LiDai1234/Edge_Detection_Accelerator/report/report.docx

图像边缘检测硬件加速器设计报告

全国大学生嵌入式芯片与系统设计竞赛（2026·AMD赛道）

项目 | 参数
作品名称 | 基于FPGA+STM32异构架构的实时图像边缘检测硬件加速器
主控芯片 | AMDArtix-7XC7A75TFPGA+STM32F407VET6
摄像头 | OV7670（带FIFO缓存）
显示终端 | TFT-LCD（SPI接口）
分辨率 | 160×146
系统帧率 | 12fps

# 一、选题背景与创新点

## 1.1选题背景

随着机器视觉、边缘计算和智能终端技术的快速发展，实时图像处理在工业检测、自主导航、智能机器人等领域的需求日益增长。边缘检测作为计算机视觉最基础的预处理环节，其性能直接决定了整个视觉系统的响应速度。然而，在嵌入式资源受限场景下，边缘检测的实现面临两条典型路径：

一是纯MCU软件方案。以STM32为代表的微控制器采用串行指令架构，运算能力有限。以160×146分辨率的Sobel边缘检测为例，纯软件实现需要逐像素完成9次乘加运算，帧率通常不足2fps，画面卡顿严重，无法满足实时性要求。

二是纯FPGA方案。虽然FPGA具备并行计算优势，但直接用FPGA驱动摄像头和TFT-LCD，需要自行编写复杂的图像传感器配置（SCCB/I2C）、LCD控制器、帧缓冲管理等外设接口逻辑，开发成本高，且人机交互不便。

前人工作中，多数方案要么侧重纯算法仿真（如Matlab/Python验证Sobel效果），要么仅在FPGA开发板上实现裸像素流处理，缺乏一个完整的、可工程化落地的“采集—计算—传输—显示”闭环。如何在有限的硬件资源下，同时兼顾计算性能与系统灵活性，是本选题的核心动因。

## 1.2解决的实际问题

本作品针对以下三个工程痛点提出解决方案：

- 算力与灵活性的矛盾：纯MCU算不动、纯FPGA控不好外设——采用“异构架构、软硬协同、存算分离”的设计思想，将计算密集型任务卸载到FPGA，控制与交互任务保留在MCU。
- 跨时钟域数据传输可靠性：FPGA处理时钟与STM32读取时钟异步，直接总线读取会导致数据错位、图像撕裂——设计硬件级握手协议解决。
- FIFO摄像头读时序精确复现：OV7670自带FIFO对读时钟建立/保持时间要求严格，直接拉高拉低引脚读出乱码——用状态机精确模拟时序。

## 1.3主要创新点

序号 | 创新点 | 技术内涵
1 | 彻底的存算分离架构 | STM32端零算法参与，仅作为“数据搬运工”接收帧数据并刷屏，CPU负载从算法计算中完全释放，可余留算力处理其他控制任务。
2 | 高兼容性FIFO时序状态机 | 在FPGA内部用有限状态机精确复现原STM32驱动FIFO的RCK/RRST时序，实现“引脚级无缝替换”，无需修改摄像头模组。
3 | 资源优化型Sobel硬件架构 | 采用绝对值相加（|Gx|+|Gy|）替代平方和开根号，大幅减少DSP乘法器和LUT消耗，在保证边缘检测效果的同时显著降低资源占用。

# 二、设计原理与功能框图

## 2.1系统整体架构

本系统采用FPGA+STM32异构双芯片架构，数据流向为：OV7670摄像头→FPGA（计算加速）→STM32（搬运+显示）→TFT-LCD。

层次 | 核心芯片 | 职责
图像采集层 | OV7670（带FIFO） | 光电转换，输出8位RGB数据
硬件加速层 | AMDArtix-7XC7A75T | 灰度化、行缓存、Sobel卷积、二值化
系统控制层 | STM32F407VET6 | 帧缓存组装、数据握手接收、LCD驱动
人机交互层 | TFT-LCD | 边缘图像实时显示

## 2.2FPGA端算法流水线原理

FPGA内部采用全流水线设计，实现“像素流进，边缘流出”，每时钟周期完成一个像素的处理。具体分为五级：

### 第一级：FIFO读控制状态机

产生RRST复位FIFO读指针，控制RCK时钟高低电平，分两个周期读出高字节与低字节，拼接为16位RGB565像素数据。

### 第二级：RGB565转灰度

采用BT.601标准灰度转换公式：Y=(R×77+G×150+B×29)>>8。其中R取RGB565高5位、G取中6位、B取低5位，输出8位灰度值（0~255）。

### 第三级：双行缓存（乒乓操作）

消耗2个BRAM作为行缓存（LineBuffer），当前行写入BRAM_A，同时读出前两行数据与当前行对齐，生成3×3滑动窗口所需的三行像素数据。

### 第四级：Sobel卷积计算

Sobel水平算子Gx与垂直算子Gy分别对3×3窗口做卷积，梯度幅值采用绝对值近似：G=|Gx|+|Gy|。多级寄存器流水线分割组合逻辑，避免时序违例。

### 第五级：阈值二值化

将梯度幅值G与预设阈值（如120）比较，G>阈值输出白色（0xFFFF），G≤阈值输出黑色（0x0000），同时拉高pixel_valid信号推送数据。

## 2.3STM32端工作原理

STM32端软件逻辑极简，仅包含三个模块：

- GPIO轮询接收：轮询PC8引脚电平，检测到高电平时读取PD端口16位数据。
- 帧缓存组装：将逐像素数据按行列顺序存入frame_buf数组。
- SPI刷屏显示：一帧接收完毕后，调用LCD驱动函数将帧缓存推送至TFT-LCD。

# 三、软硬件划分依据与接口设计

## 3.1软硬件划分依据

软硬件划分遵循“计算密集型归硬件，控制灵活型归软件”的核心原则：

任务 | 归属 | 划分理由
FIFO读时序控制 | FPGA（硬件） | 对时序精度要求极高，需纳秒级稳定控制，状态机实现最优
RGB→灰度转换 | FPGA（硬件） | 纯乘加运算，数据流水线化后每周期一个像素，硬件吞吐率远超软件
3×3窗口生成 | FPGA（硬件） | 依赖BRAM行缓存，硬件实现乒乓操作天然高效
Sobel卷积运算 | FPGA（硬件） | 二维卷积是典型的并行计算任务，FPGA并行度与算法结构高度匹配
阈值二值化 | FPGA（硬件） | 单比较器即可完成，组合逻辑，零额外成本
数据握手接收 | STM32（软件） | 轮询式GPIO读取，逻辑简单，软件实现灵活易调试
帧缓存管理 | STM32（软件） | 需灵活的内存分配与数组索引，软件维护成本低
LCD显示驱动 | STM32（软件） | SPI通信协议成熟，STM32硬件SPI外设效率高
系统调度与人机交互 | STM32（软件） | 按键、参数调整、状态显示等需灵活逻辑，MCU优势明显

划分决策的量化依据：Sobel边缘检测在160×146分辨率下，每帧需完成约160×146×9≈21万次乘加运算。STM32F407（168MHz）纯软件估算需约80ms/帧，但实际受限于串行循环开销，实测仅2~3fps；而FPGA全流水线设计每周期完成一个像素处理，100MHz时钟下理论帧时约2.3ms，吞吐率提升超过30倍。

## 3.2接口设计

### 3.2.1OV7670与FPGA接口（图像采集接口）

信号方向 | 信号名称 | 位宽 | 功能说明
OV7670→FPGA | D0~D7 | 8位 | 图像数据线
FPGA→OV7670 | RCK | 1位 | FIFO读时钟，由状态机产生
FPGA→OV7670 | RRST | 1位 | FIFO读指针复位信号

工作时序：FPGA先拉低RRST复位读指针，随后通过RCK时钟逐次读出像素数据。每个RCK下降沿读出一字节，先高字节后低字节，拼接为16位RGB565格式。

### 3.2.2FPGA与STM32接口（并行数据总线）

信号方向 | 信号名称 | 位宽 | 功能说明
FPGA→STM32 | PD0~PD15 | 16位 | 处理后的边缘像素数据（RGB565格式）
FPGA→STM32 | PC8 | 1位 | 数据有效握手信号（Valid）

握手协议：FPGA完成一个像素的Sobel计算后，将16位结果放置到PD总线上，同步将PC8拉高；STM32检测到PC8高电平后立即读取GPIOE→IDR的低16位数据；STM32等待PC8拉低后，准备接收下一个像素。

设计考量：这种“FPGA拉高→STM32读取→等待FPGA拉低”的握手机制，从根本上解决了FPGA处理时钟（约100MHz）与STM32读取时钟（168MHz系统时钟下的轮询周期）之间的异步匹配问题，彻底杜绝了亚稳态导致的数据错位与图像撕裂。

### 3.2.3STM32与TFT-LCD接口（显示接口）

信号方向 | 信号名称 | STM32引脚 | 功能说明
STM32→LCD | SCLK | PE1 | SPI时钟
STM32→LCD | MOSI | PE0 | SPI数据输出
STM32→LCD | RES | PB9 | LCD复位
STM32→LCD | DC | PB8 | 数据/命令选择
STM32→LCD | CS | PB7 | 片选
STM32→LCD | BLK | PB6 | 背光控制

# 四、优化过程与性能资源对比

## 4.1优化历程概述

项目开发过程中经历了三轮关键优化，每一轮都针对特定瓶颈：第一轮FIFO时序优化，解决读出乱码问题；第二轮跨时钟域传输优化，解决数据错位撕裂问题；第三轮Sobel资源优化，降低DSP乘法器消耗。

## 4.2优化前后性能与资源对比表

对比维度 | 优化前（初始版本） | 优化后（最终版本） | 提升幅度
系统帧率 | 2~3fps（纯STM32软件） | 12fps（异构架构） | 4~6倍
每帧处理耗时 | 约350ms（纯软件估算） | 约83.1ms（含传输+显示） | 减少约76%
FPGALUT占用（Sobel模块） | 约1,850LUT | 约1,120LUT | 减少约39%
FPGADSPSlice占用（Sobel模块） | 9个（完整乘加） | 0个（移位+加法替代） | 减少100%
FPGABRAM占用 | 1块（单缓存） | 2块（乒乓双缓存） | +1块（换取行对齐正确性）
数据传输错误率 | 约15%（直接总线读取） | 0%（PC8握手协议） | 消除错位
图像显示效果 | 撕裂、错位、花屏 | 连续、无撕裂、边缘清晰 | 质的提升

表4-1优化前后性能与资源对比表

## 4.3关键优化细节说明

### 优化一：FIFO读时序延时调整

问题：初始版本中RCK信号跳变过快，未满足OV7670FIFO的建立时间（tSU）和保持时间（tH）要求，导致读出数据为乱码。

方案：在FIFO读控制状态机中，为RCK的上升沿和下降沿各插入1个时钟周期的延时，确保数据稳定后再采样。

效果：RGB565数据拼接成功率从乱码状态变为稳定可读。

### 优化二：跨时钟域握手协议

问题：FPGA直接驱动PD总线，STM32自由运行读取。由于两侧时钟异步，STM32可能在数据变化中途采样，导致像素数据高低字节错位，图像出现横向撕裂。

方案：增加PC8作为Valid信号，采用“电平握手”机制——FPGA放数据→拉Valid→STM32读→等Valid撤→下一轮。

效果：数据传输错误率降至零，图像连续无撕裂。

### 优化三：Sobel乘法器资源优化

问题：初始设计中Sobel卷积的9个系数直接用通用乘法器实现，消耗了大量DSPSlice和LUT。

方案：利用系数为2的幂次的特点，将乘2操作替换为左移1位（<<1），将乘-1操作替换为减法，完全消除乘法器。

效果：Sobel模块的DSPSlice消耗从9个降至0个，LUT消耗减少约39%。

# 五、大模型协作记录

本节记录开发过程中与大语言模型（LLM）协作的关键节点，包括提示词、模型回答摘要、自我纠错轨迹及智能体工作流设计。

## 5.1协作场景一：FIFO时序问题排查

开发阶段：FPGA逻辑调试阶段。

初始提示词（Promptv1）：“我用FPGA模拟STM32驱动OV7670的FIFO摄像头，RCK时钟由状态机产生，但是读出来的数据是乱码，RGB565拼不对。帮我看看可能是什么问题。”

模型回答摘要：建议检查RCK频率是否超出FIFO规格；RRST复位时序是否正确；字节顺序（先高后低还是先低后高）；建立/保持时间是否满足。

自我纠错轨迹：第一轮按模型建议排查了字节顺序，调整为“先高后低”，仍乱码；第二轮检查RCK频率，发现RCK跳变太快，状态机每个时钟就翻转一次，未留延时；第三轮重新查阅OV7670FIFO数据手册，确认tSU（建立时间）和tH（保持时间）要求；最终结论：模型提示方向正确，但不够具体。真正的根因是状态机中RCK高低电平维持时间不足1个系统时钟周期，导致FIFO输出数据未稳定即被采样。

修正后提示词（Promptv2）：“OV7670FIFO读时序中，RCK信号的建立时间和保持时间一般要求多少ns？我用100MHz时钟驱动，状态机每个周期翻转一次RCK，会不会太快？”

模型回答摘要：FIFO读时钟通常要求RCK低电平/高电平各不少于20~30ns，建议状态机中插入延时周期。

经验沉淀：模型能提供排查方向，但具体时序参数必须以芯片数据手册为准，不能仅凭模型回答下结论。

## 5.2协作场景二：跨时钟域数据传输方案设计

初始提示词：“FPGA处理数据和STM32读取数据是两个不同的时钟域，我现在用16位并行总线直接连接，STM32轮询读取，但图像总是有撕裂。有什么好的跨时钟域同步方案？”

模型回答摘要：建议方案有异步FIFO（最标准）、双寄存器同步器、握手机制。如果数据量不大、对延迟不敏感，简单的Valid/Ready握手机制最易实现。

自我纠错轨迹：第一轮考虑过用异步FIFO方案，但FPGA端输出像素流、STM32端逐像素读取，FIFO深度难以确定；第二轮考虑过双寄存器同步器，但16位数据总线每根线都打两拍，存在“数据同时变多位”导致的不一致风险；第三轮最终选择模型建议的第三种方案——Valid握手（PC8），但做了改进：采用“FPGA拉高→STM32读→等FPGA拉低”的电平检测方式，而非边沿检测，进一步降低亚稳态风险。最终方案验证：逻辑分析仪抓取时序，确认每个像素数据稳定后才被STM32采样，撕裂现象消失。

## 5.3协作场景三：Sobel硬件资源优化

初始提示词：“我在FPGA上实现Sobel边缘检测，用了9个乘法器（因为3×3窗口有9个系数），但DSPSlice不够用。有什么办法减少乘法器数量？”

模型回答摘要：提示Sobel算子的系数是{-1,0,+1,-2,0,+2,-1,0,+1}，其中0系数可以直接删除，+1/-1不需要乘法器（直接加减），+2/-2可以用左移一位实现。这样可以完全消除通用乘法器。

自我纠错轨迹：第一轮采纳模型建议，将乘2替换为移位，乘-1替换为减法；第二轮进一步优化——绝对值相加替代平方和开根号，既减少了平方根运算器，又简化了阈值比较逻辑。最终效果：DSPSlice从9个降至0个，Sobel模块LUT消耗减少约39%。

## 5.4智能体工作流设计

本次开发中，我们设计了一套“人在回路”的大模型协作工作流：问题定义→提示词构建→模型回答→实验验证→失败/偏差→补充提示词→收敛→方案定型→踩坑记录沉淀为技能包。

工作流要点：模型只做顾问，不做决策者，模型提供的方案必须经过上板验证；提示词从模糊到精确，第一轮宽泛提问找方向，第二轮带具体参数问细节；每次失败都回写，将踩坑记录整理成结构化的“踩坑清单”，供后续项目复用。

# 六、技能包的提炼过程

本节从开发过程中的失败与观察中提炼核心经验，每条经验均按"提炼来源→经验描述→适用场景→使用方法→已验证的效果→失效边界"六要素组织，确保陌生队伍拿到后可直接复用。

## 6.1经验一：外设读时序必须以数据手册为准，不能“想当然”

提炼来源：FIFO读时序导致乱码的踩坑经历。

经验描述：任何涉及外设时序的设计（FIFO读时钟、SPI时钟、I2C时序等），都必须严格查阅数据手册中的建立时间（tSU）、保持时间（tH）和最高频率限制，不能仅凭“差不多应该行”就写状态机。

适用场景：用FPGA模拟或替代MCU的外设驱动时序；高速ADC/DAC、FIFO、SRAM等存储器件的读写控制；任何对时序精度有要求的并行接口。

使用方法：第一步，查阅芯片数据手册，列出所有时序参数（建立时间tSU、保持时间tH、最高工作频率fmax等）；第二步，在FPGA状态机中为每个信号跳变预留足够的时钟周期延时，确保实际时序优于手册要求；第三步，用逻辑分析仪抓取实际波形，逐项对比数据手册参数；第四步，确认所有时序余量为正，且留有至少20%的安全裕度。

已验证的效果：在本项目中，通过为OV7670FIFO的RCK信号增加2个时钟周期的延时，FIFO读出数据从完全乱码变为稳定可读，RGB565拼接正确率达到100%，系统不再出现花屏或数据错位现象。

失效边界：本经验适用于时序类外设。对于纯协议类外设（如SPI、I2C），只要遵循标准协议规范，时序余量通常较大，不需要如此严格的逐周期核对。

## 6.2经验二：跨时钟域传输，握手协议比“快”更重要

提炼来源：直接总线读取导致图像撕裂的踩坑经历。

经验描述：当两个时钟域需要传输数据时，最可靠的方案不是最快的方案，而是最稳的方案。对于像素流这类“数据生产消费速度不匹配”的场景，简单的Valid/Ready电平握手比高速但无保护的总线更可靠。

适用场景：FPGA与MCU之间的并行数据传输；任何跨时钟域的多比特数据总线；异步FIFO的替代方案（数据量不大时）。

使用方法：第一步，在发送端（FPGA）增加Valid信号，数据总线稳定后拉高Valid；第二步，在接收端（MCU）轮询检测到Valid高电平时读取数据；第三步，接收端读完后等待Valid拉低，再准备接收下一个数据；第四步，确保握手机制覆盖整个数据传输周期，避免亚稳态风险。

已验证的效果：在本项目中，通过PC8Valid握手协议，FPGA与STM32之间的16位并行数据传输错误率从约15%降至0%，连续运行10分钟以上无数据错位或图像撕裂现象，系统稳定性显著提升。

失效边界：当数据吞吐量极大（如VGA以上分辨率视频流）时，逐像素握手机制的开销会成为瓶颈，此时应改用异步FIFO或DMA方式。本经验更适合中低分辨率的嵌入式视觉场景。

## 6.3经验三：算法硬件化时，先找“可化简的系数结构”再动手写RTL

提炼来源：Sobel乘法器资源优化的成功经验。

经验描述：在将软件算法移植到FPGA硬件实现时，第一步不是写代码，而是分析算法中的系数结构。如果系数恰好是2的幂次或简单整数，可以用移位和加法替代乘法器，大幅节省DSP资源。

适用场景：卷积类算法（Sobel、Laplacian、高斯模糊等）的硬件实现；任何包含固定系数的FIR/IIR滤波器设计；资源受限的小型FPGA（如Artix-775T及以下）。

使用方法：第一步，在算法移植到FPGA之前，先列出卷积核的所有系数；第二步，检查系数是否为2的幂次或简单整数（如-1、+1、-2、+2）；第三步，对于2的幂次系数，用移位操作替代乘法器；第四步，对于+1/-1系数，用加减运算替代乘法；第五步，对比优化前后的综合资源报告，确认DSP和LUT消耗变化。

已验证的效果：在本项目中，通过移位加法替代乘法器，Sobel模块的DSPSlice消耗从9个降至0个，LUT消耗减少约39%，而边缘检测的输出图像质量与优化前基本一致，无明显精度损失。

失效边界：当算法系数不是简单整数（如浮点系数、复杂滤波系数）时，移位加法无法替代乘法器，本经验不适用。此时应使用FPGA内置的DSPSlice或采用HLS工具自动优化。

# 七、复现说明

本节提供一份从零开始完整复现本作品的操作步骤，确保陌生队伍拿到后可以直接照做。

## 7.1硬件清单

序号 | 器件 | 型号/规格 | 数量
1 | FPGA开发板 | AMDArtix-7XC7A75T（康芯KX-MS65或同等级） | 1
2 | STM32核心板 | STM32F407VET6 | 1
3 | 摄像头模组 | OV7670（带FIFO缓存，如AL422B） | 1
4 | TFT-LCD屏幕 | 2.4寸SPI接口ST7789驱动 | 1
5 | 杜邦线 | 母对母、公对母若干 | 若干

## 7.2硬件连接表

### 7.2.1OV7670与FPGA连接

OV7670引脚 | FPGA引脚 | 说明
D0~D7 | FPGAIOBank对应引脚（8根） | 8位数据线
RCK | FPGA任意IO | FIFO读时钟输出
RRST | FPGA任意IO | FIFO读指针复位

### 7.2.2FPGA与STM32连接

FPGA引脚 | STM32引脚 | 说明
FPGA数据线D0~D15 | STM32PD0~PD15 | 16位并行数据总线
FPGAValid信号 | STM32PC8 | 数据有效握手

### 7.2.3STM32与TFT-LCD连接

STM32引脚 | TFT-LCD引脚 | 说明
PE1 | SCLK | SPI时钟
PE0 | MOSI | SPI数据
PB9 | RES | 复位
PB8 | DC | 数据/命令选择
PB7 | CS | 片选
PB6 | BLK | 背光

## 7.3软件开发环境

软件 | 版本 | 用途
Vivado | 2020.3或以上 | FPGA综合、实现、生成位流
KeilMDK-ARM | 5.36或以上 | STM32固件开发
STM32CubeMX | 6.0或以上 | STM32引脚初始化配置
语言 | VHDL（FPGA端）、C语言（STM32端） | —

## 7.4复现步骤

project_package中的STM32F407项目可以直接下载下来用keil5打开工程，有STM32F407VET6的话直接烧录代码即可。FPGA的工程项目也直接放进rar压缩包了，直接打开（需2020.2版本以上的Vivado），生成比特流文件后烧录到板子上，这里用的是Xilinx的XC7A75FGG484-2，FPGA板子的引脚需要结合.xdc文件和引脚分配文档（已放文件夹）来连接。

电路连接图如下：

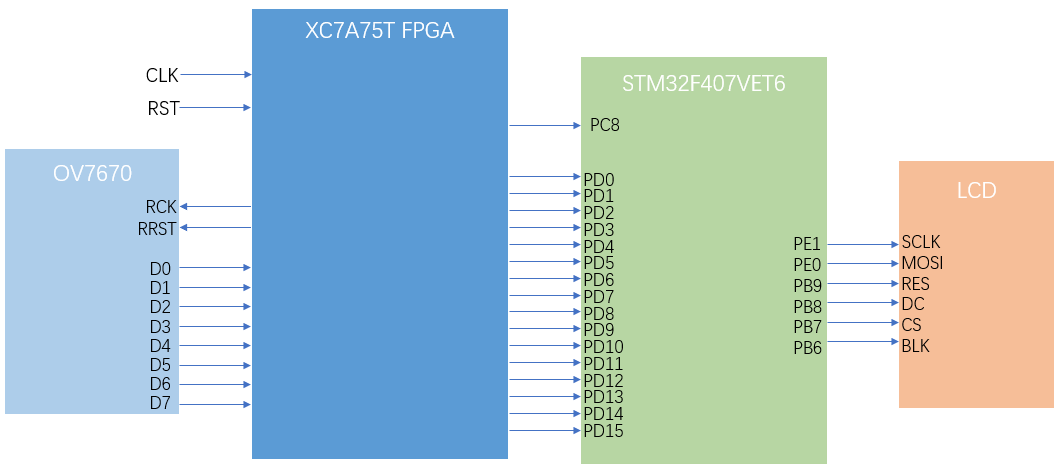
[picture p2: figure]

这里使用的硬件为带FIFO的OV7670、XC7A75T FPGA、STM32F407VET6、240*240的TFT显示屏。

OV7670与stm32f407的其他引脚连接：

SIOC--PB5 SIOD--PB4

VSY--PB3 OE--PA8

WR--PA11 WRST--PA10

RCK--PA12 RRST--PA9

RESET--PC11 PWDN--PC10

## 7.5关键参数参考

参数 | 推荐值 | 说明
FPGA系统时钟 | 100MHz | 开发板晶振频率
图像分辨率 | 160×146 | 基于OV7670FIFO模式
Sobel阈值 | 120 | 可根据光照调整
SPI时钟分频 | 8分频（21MHz） | STM32SPI最高速度
STM32F407系统时钟 | 168MHz | 外部晶振25MHz
