LiDai1234/Edge_Detection_Accelerator/data/README.md

可能出现的问题及解决部分：  
1.配置ov7670的寄存器0x70和0x71进入彩条模式时，如果已经出现竖直彩条，  
&nbsp;&nbsp;但彩条在向右移动（如图picture_4）则大概率是WRST没复位成功，拉低时延时一段时间再拉高  
2.出现picture_3这种情况时，大概率是一个像素对应的两个字节位置反了，要么接线换下位置，要么代码改下像素的高地字节  
3.picture_2是不加FPGA进去，将OV7670的D0~D7接stm32，改下读数据帧部分，  
&nbsp;&nbsp;也就是不加边缘检测时输出的正常画面，picture_1是正常边缘检测后输出的图像
