LiDai1234/Edge_Detection_Accelerator/skill/README.md

```text
【提示词模板】
我正在使用 [FPGA型号] 和 [MCU型号] 进行异构视觉系统开发。目标算法是 [算法名称，如：Sobel边缘检测/卷积神经网络]。
请帮我设计软硬协同的架构，要求：
1. 划分FPGA端（负责高吞吐量、并行流水线计算）和MCU端（负责控制、外设交互、显示）的职责边界。
2. 针对该算法，设计FPGA内部的硬件流水线模块（包括数据缓存、窗口生成、核心计算、阈值输出等）。
3. 设计FPGA与MCU之间的通信接口。如果采用并行总线，请设计握手信号（如 Valid/Ready 机制）以保证跨时钟域不丢数、不错位。
4. 列出MCU端需要配合的驱动代码逻辑（如轮询、中断或DMA）。
