LiDai1234/Edge_Detection_Accelerator/7A75_pin_config.docx

#### 时钟引脚分配：

时钟引脚名称 | FPGA 引脚
CLK | Y18

JTAG引脚分配表

引脚名 | FPGA引脚
T13 | FPGA_TMS
U13 | FPGA_TDO
R13 | FPGA_TDI
V12 | FPGA_TCK

TF引脚分配表

引脚名 | FPGA引脚
D0 | J20
D1 | J22
D2 | H22
CD/D3 | J21
CMD | K22
CLK | P20

N25Q128引脚分配表

引脚名 | FPGA引脚
QSPI_D3 | R21
QSPI_D2 | P21
QSPI_D0 | P22
QSPI_D1 | R22
QSPI_CS | T19
QSPI_CLK | L12

4个独立LED引脚分配：

按键名称 | FPGA 引脚
LED0 | AB21
LED1 | AB22
LED2 | W21
LED3 | W22

FT2232引脚分配：

按键名称 | FPGA 引脚
USB_TXD | G13
USB_RXD | G15

#### 按键引脚分配：

按键名称 | FPGA 引脚
K1 | E3
K2 | G4
K3 | V22
K4 | T21

DDR3的引脚分配表

引脚名 | FPGA引脚 | FPGA引脚名 | 引脚名
DDR3_WE | R1 | N3 | DDR3_A7
DDR3_UDQS_P | E1 | N5 | DDR3_A6
DDR3_UDQS_N | D1 | M1 | DDR3_A5
DDR3_UDM | D2 | M5 | DDR3_A4
DDR3_RESET | F4 | L1 | DDR3_A3
DDR3_RAS | P1 | M3 | DDR3_A2
DDR3_ODT | J4 | M6 | DDR3_A1
DDR3_LDQS_P | K2 | L3 | DDR3_A0
DDR3_LDQS_N | J2 | B2 | DDR3_DQ15
DDR3_LDM | G3 | F1 | DDR3_DQ14
DDR3_CS | K4 | A1 | DDR3_DQ13
DDR3_CLK_P | P5 | E2 | DDR3_DQ12
DDR3_CLK_N | P4 | B1 | DDR3_DQ11
DDR3_CKE | J6 | G1 | DDR3_DQ10
DDR3_CAS | P2 | C2 | DDR3_DQ9
DDR3_BA2 | L4 | F3 | DDR3_DQ8
DDR3_BA1 | L5 | K1 | DDR3_DQ7
DDR3_BA0 | K3 | H4 | DDR3_DQ6
DDR3_A13 | N4 | J1 | DDR3_DQ5
DDR3_A12 | L6 | J5 | DDR3_DQ4
DDR3_A11 | P6 | H2 | DDR3_DQ3
DDR3_A10 | K6 | H5 | DDR3_DQ2
DDR3_A9 | M2 | H3 | DDR3_DQ1
DDR3_A8 | N2 | G2 | DDR3_DQ0

引脚名 | FPGA引脚
XADC_VP S2 | L10
XADC_VN S1 | M9
NetR16_1 | U12
FPGA_PUDC | U22
FPGA_PROGRAM_B | N12
FPGA_DONE | G11

#### JP1 扩展口引脚分配表

40P扩展口编号 | 信号名 | FPGA 引脚 | 备注
1 | P1IO[0] | J17 | 输入输出
2 | P1IO[1] | H19 | 输入输出
3 | P1IO[2] | K16 | 输入输出
4 | P1IO[3] | K13 | 输入输出
5 | P1IO[4] | K18 | 输入输出
6 | P1IO[5] | K17 | 输入输出
7 | P1IO[6] | L18 | 输入输出
8 | P1IO[7] | L19 | 输入输出
9 | P1IO[8] | L16 | 输入输出
10 | P1IO[9] | K19 | 输入输出
11 | VCC_5V
12 | GND
13 | P1IO[10] | K14 | 输入输出
14 | P1IO[11] | L15 | 输入输出
15 | P1IO[12] | L13 | 输入输出
16 | P1IO[13] | L14 | 输入输出
17 | P1IO[14] | M22 | 输入输出
18 | P1IO[15] | M20 | 输入输出
19 | P1IO[16] | N14 | 输入输出
20 | P1IO[17] | L20 | 输入输出
21 | P1IO[18] | M18 | 输入输出
22 | P1IO[19] | N19 | 输入输出
23 | P1IO[20] | N22 | 输入输出
24 | P1IO[21] | N20 | 输入输出
25 | P1IO[22] | N18 | 输入输出
26 | P1IO[23] | M17 | 输入输出
27 | P1IO[24] | N17 | 输入输出
28 | P1IO[25] | M16 | 输入输出
29 | VCC_3V3
30 | GND
31 | P1IO[26] | M15 | 输入输出
32 | P1IO[27] | P17 | 输入输出
33 | P1IO[28] | P16 | 输入输出
34 | P1IO[29] | R17 | 输入输出
35 | P1IO[30] | N15 | 输入输出
36 | P1IO[31] | R16 | 输入输出
37 | P1IO[32] | V20 | 输入输出
38 | P1IO[33] | R18 | 输入输出
39 | P1IO[34] | T18 | 输入输出
40 | P1IO[35] | U20 | 输入输出

#### JP2 扩展口引脚分配表

40P扩展口编号 | 信号名 | FPGA 引脚 | 备注
1 | P1IO[0] | J17 | 输入输出
2 | P1IO[1] | H19 | 输入输出
3 | P1IO[2] | K16 | 输入输出
4 | P1IO[3] | K13 | 输入输出
5 | P1IO[4] | K18 | 输入输出
6 | P1IO[5] | K17 | 输入输出
7 | P1IO[6] | L18 | 输入输出
8 | P1IO[7] | L19 | 输入输出
9 | P1IO[8] | L16 | 输入输出
10 | P1IO[9] | K19 | 输入输出
11 | VCC_5V
12 | GND
13 | P1IO[10] | K14 | 输入输出
14 | P1IO[11] | L15 | 输入输出
15 | P1IO[12] | L13 | 输入输出
16 | P1IO[13] | L14 | 输入输出
17 | P1IO[14] | M22 | 输入输出
18 | P1IO[15] | M20 | 输入输出
19 | P1IO[16] | N14 | 输入输出
20 | P1IO[17] | L20 | 输入输出
21 | P1IO[18] | M18 | 输入输出
22 | P1IO[19] | N19 | 输入输出
23 | P1IO[20] | N22 | 输入输出
24 | P1IO[21] | N20 | 输入输出
25 | P1IO[22] | N18 | 输入输出
26 | P1IO[23] | M17 | 输入输出
27 | P1IO[24] | N17 | 输入输出
28 | P1IO[25] | M16 | 输入输出
29 | VCC_3V3
30 | GND
31 | P1IO[26] | M15 | 输入输出
32 | P1IO[27] | P17 | 输入输出
33 | P1IO[28] | P16 | 输入输出
34 | P1IO[29] | R17 | 输入输出
35 | P1IO[30] | N15 | 输入输出
36 | P1IO[31] | R16 | 输入输出
37 | P1IO[32] | V20 | 输入输出
38 | P1IO[33] | R18 | 输入输出
39 | P1IO[34] | T18 | 输入输出
40 | P1IO[35] | U20 | 输入输出

#### JP3 扩展口引脚分配表

40P扩展口编号 | 信号名 | FPGA 引脚 | 备注
1 | P3IO[0] | Y22 | 输入输出
2 | P3IO[1] | W19 | 输入输出
3 | P3IO[2] | AA19 | 输入输出
4 | P3IO[3] | Y21 | 输入输出
5 | P3IO[4] | U17 | 输入输出
6 | P3IO[5] | U18 | 输入输出
7 | P3IO[6] | W17 | 输入输出
8 | P3IO[7] | V17 | 输入输出
9 | P3IO[8] | P14 | 输入输出
10 | P3IO[9] | R14 | 输入输出
11 | VCC_5V
12 | GND
13 | P3IO[10] | V8 | 输入输出
14 | P3IO[11] | V9 | 输入输出
15 | P3IO[12] | U6 | 输入输出
16 | P3IO[13] | V7 | 输入输出
17 | P3IO[14] | T5 | 输入输出
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
32 | P7IO[27] | H22 | 输入输出
33 | P7IO[28] | J20 | 输入输出
34 | P7IO[29] | J21 | 输入输出
35 | P7IO[30] | J22 | 输入输出
36 | P7IO[31] | K22 | 输入输出
37 | P7IO[32] | K21 | 输入输出
38 | P7IO[33] | L21 | 输入输出
39 | P7IO[34] | M21 | 输入输出
40 | P7IO[35] | P20 | 输入输出

动态配置IO实验电路结构引脚对照表（KXC7A35/75T）

序号 | PIO号（实验箱） | 7A35/75T引脚 | 脚位号 | JP40座位号
1 | PIO[15] | R3 | 37 | JP4
2 | PIO[14] | U1 | 35 | JP4
3 | PIO[13] | Y2 | 33 | JP4
4 | PIO[12] | AA3 | 31 | JP4
5 | PIO[11] | AA4 | 27 | JP4
6 | PIO[10] | Y6 | 25 | JP4
7 | PIO[9] | Y7 | 23 | JP4
8 | PIO[8] | AB8 | 21 | JP4
9 | PIO[7] | U2 | 38 | JP4
10 | PIO[6] | V3 | 36 | JP4
11 | PIO[5] | Y1 | 34 | JP4
12 | PIO[4] | W4 | 32 | JP4
13 | PIO[3] | W5 | 28 | JP4
14 | PIO[2] | AA6 | 26 | JP4
15 | PIO[1] | AB7 | 24 | JP4
16 | PIO[0] | W9 | 22 | JP4
17 | PO[31] | U17 | 5 | JP3
18 | PO[30] | U18 | 6 | JP3
19 | PO[29] | W17 | 7 | JP3
20 | PO[28] | V17 | 8 | JP3
21 | PO[27] | P14 | 9 | JP3
22 | PO[26] | R14 | 10 | JP3
23 | PO[25] | V8 | 13 | JP3
24 | PO[24] | V9 | 14 | JP3
25 | PO[23] | U6 | 15 | JP3
26 | PO[22] | V7 | 16 | JP3
27 | PO[21] | T5 | 17 | JP3
28 | PO[20] | U5 | 18 | JP3
29 | PO[19] | Y9 | 19 | JP3
30 | PO[18] | R4 | 20 | JP3
31 | PO[17] | Y8 | 21 | JP3
32 | PO[16] | AA8 | 22 | JP3
33 | PO[15] | AB6 | 23 | JP3
34 | PO[14] | W7 | 24 | JP3
35 | PO[13] | AA5 | 25 | JP3
36 | PO[12] | AB5 | 26 | JP3
37 | PO[11] | AB3 | 27 | JP3
38 | PO[10] | Y4 | 28 | JP3
39 | PO[9] | AB1 | 31 | JP3
40 | PO[8] | AB2 | 32 | JP3
41 | PO[7] | AA1 | 33 | JP3
42 | PO[6] | Y3 | 34 | JP3
43 | PO[5] | W2 | 35Y19 | JP3
44 | PO[4] | W1 | 36 | JP3
45 | PO[3] | V2 | 37 | JP3
46 | PO[2] | U3 | 38 | JP3
47 | PO[1] | T3 | 39 | JP3
48 | PO[0] | T1 | 40 | JP3
49 | PI[15] | AA21 | 3 | JP4
50 | PI[14] | AA20 | 4 | JP4
51 | PI[13] | AB20 | 5 | JP4
52 | PI[12] | Y19 | 6 | JP4
53 | PI[11] | V18 | 7 | JP4
54 | PI[10] | P15 | 8 | JP4
55 | PI[9] | AB18 | 9 | JP4
56 | PI[8] | AA18 | 10 | JP4
57 | PI[7] | M13 | 13 | JP4
58 | PI[6] | N13 | 14 | JP4
59 | PI[5] | T6 | 15 | JP4
60 | PI[4] | U7 | 16 | JP4
61 | PI[3] | V5 | 17 | JP4
62 | PI[2] | W6 | 18 | JP4
63 | PI[1] | T4 | 19 | JP4
64 | PI[0] | R6 | 20 | JP4
65 | ps2 1 | Y21 | 4 | JP3
66 | ps2 2 | AA19 | 3 | JP3
67 | ps2 3 | W20 | 2 | JP4
68 | ps2 4 | V19 | 1 | JP4
69 | CLOCK_IN | V4 | 40 | JP4
