LiDai1234/Edge_Detection_Accelerator/data/picture_1.jpg

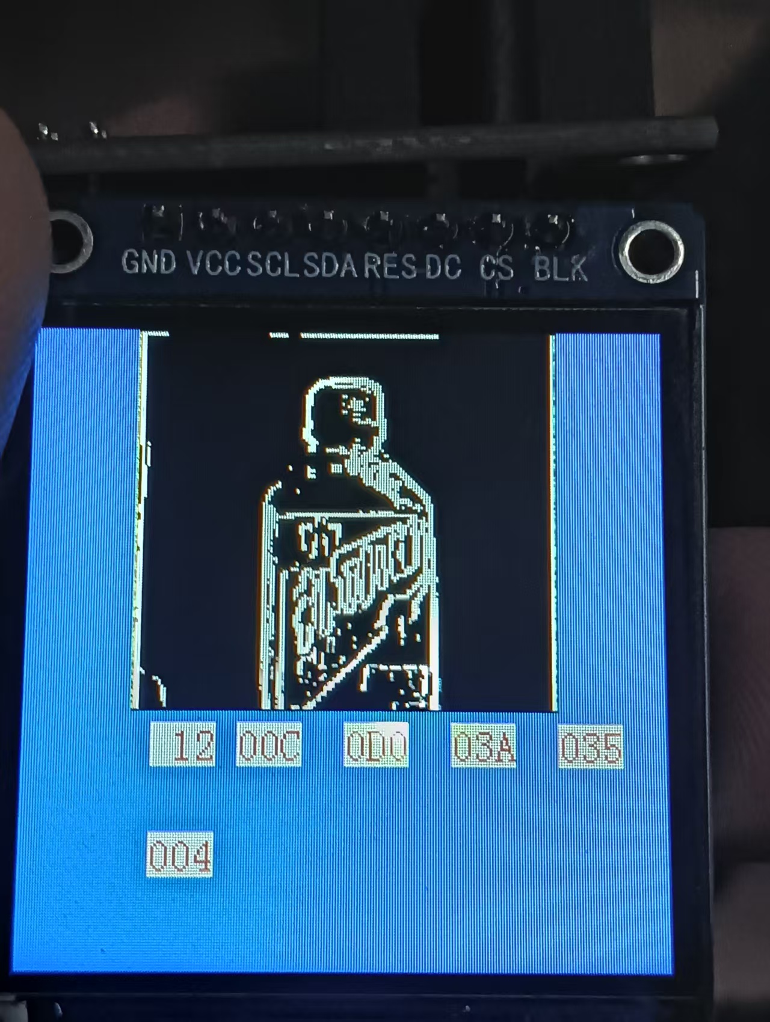
data/picture_1.jpg
