LiDai1234/Edge_Detection_Accelerator/data/picture_2.jpg

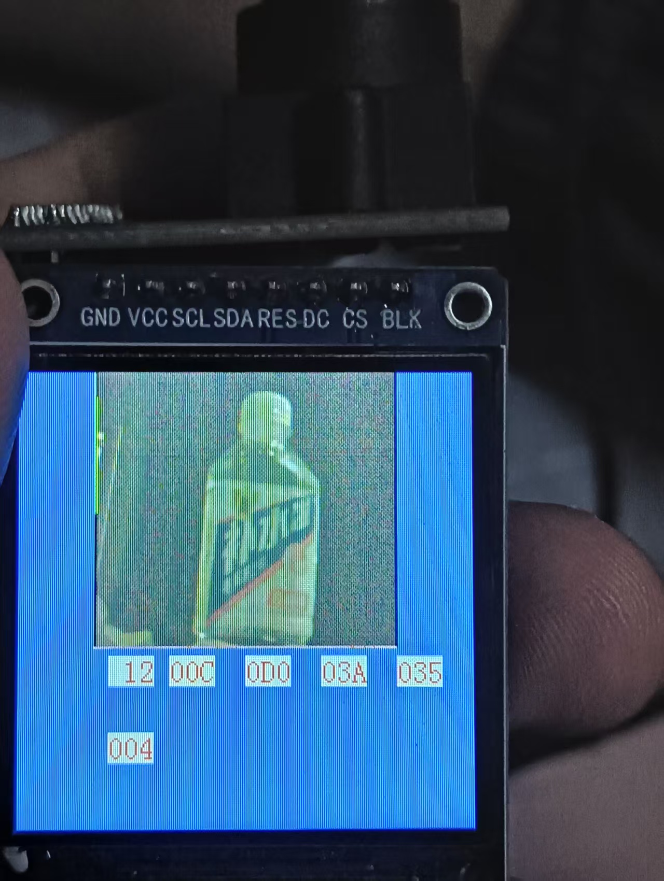
data/picture_2.jpg
