LiDai1234/Edge_Detection_Accelerator/data/picture_3.jpg

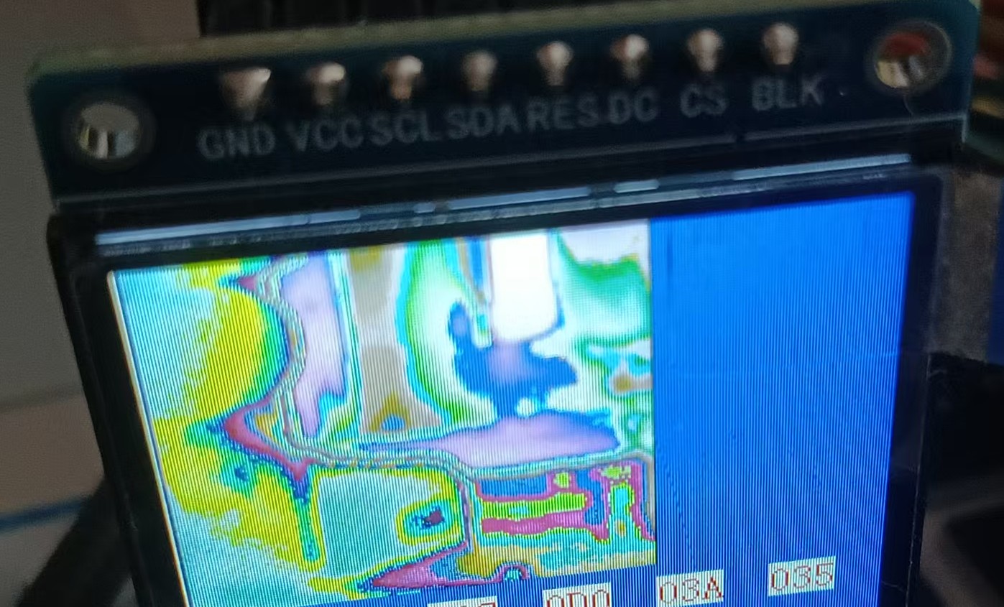
data/picture_3.jpg
