LiDai1234/Edge_Detection_Accelerator/data/picture_4.jpg

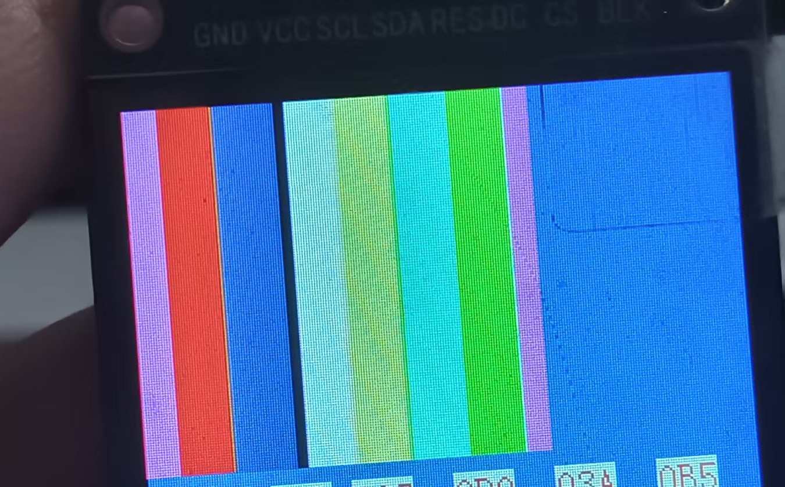
data/picture_4.jpg
