LiDai1234/Edge_Detection_Accelerator/project_package/Camera_STM32F407/Core/Src/main.c

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
/* Includes ------------------------------------------------------------------*/
#include "main.h"
#include "gpio.h"

/* USER CODE BEGIN Includes */
#include <stdlib.h> // 为了使用 abs() 函数
#include "lcd.h"
#include "lcd_init.h"
#include "pic.h"
#include "HAL_Delay.h"
#include "sccb.h"
#include "ov7670.h"
#include "user_exti.h"
#include "FPGA_connect.h"

/* USER CODE END Includes */


void SystemClock_Config(void);
/* USER CODE BEGIN PFP */
uint8_t frame_buf[IMG_WIDTH * IMG_HEIGHT * 2]; 

//uint32_t value = 0;
/* USER CODE END PFP */

/* USER CODE BEGIN 0 */


void OV7670_tftlcd(void)
{
	uint16_t i, j;
	uint32_t idx = 0; 

	if(frame_flag)
	{
		for(i = 0; i < IMG_HEIGHT; i++)
		{
			for(j = 0; j < IMG_WIDTH; j++)
			{
				// 等待 FPGA 拉高 PC8
                while (HAL_GPIO_ReadPin(GPIOC, GPIO_PIN_8) == GPIO_PIN_RESET);
				
                uint16_t pixel = (uint16_t)(GPIOE->IDR & 0xFFFF);

                // 将像素拆分为两个字节存入 frame_buf（保持 RGB565 格式）
                frame_buf[idx]     = (uint8_t)(pixel >> 8);   // 高字节
                frame_buf[idx + 1] = (uint8_t)(pixel & 0xFF); // 低字节
                idx += 2;
			}
		}
		//value = idx; //看一帧有多少字节
		LCD_ShowPicture(40, 0, IMG_WIDTH, IMG_HEIGHT, frame_buf);
		frame_cnt++;
		frame_flag = 0;
//		EXTI->IMR |= (1U << 3);
	}
}
/* USER CODE END 0 */

/**
  * @brief  The application entry point.
  * @retval int
  */
int main(void)
{

  /* MCU Configuration--------------------------------------------------------*/

  /* Reset of all peripherals, Initializes the Flash interface and the Systick. */
  HAL_Init();

  /* Configure the system clock */
  SystemClock_Config();

  /* Initialize all configured peripherals */
  MX_GPIO_Init();
  /* USER CODE BEGIN 2 */
  LCD_Init();
  OV7670_Init();
  FPGA_DATA_Init();
  //OV7670_Window_Set(12, 3, 183, 144);
  FPGA_PC8_Init();
  OV7670_PB3_EXTI_Init();
  HAL_GPIO_WritePin(GPIOA, GPIO_PIN_8, GPIO_PIN_RESET);  //OE PA8 低有效输出

  LCD_Fill(0,0,LCD_W,LCD_H,BLUE);//指定区域填充颜色

  uint8_t val1 = SCCB_Read_Reg(0x12);  //读取寄存器
	uint8_t val2 = SCCB_Read_Reg(0x40);  //读取寄存器
	uint8_t val3 = SCCB_Read_Reg(0x70);  //读取寄存器
	uint8_t val4 = SCCB_Read_Reg(0x71);  //读取寄存器
	uint8_t val5 = SCCB_Read_Reg(0x3a);  //读取寄存器
	uint8_t val6 = GPIOD->IDR;
  /* USER CODE END 2 */

  /* Infinite loop */
  /* USER CODE BEGIN WHILE */
  while (1)
  {
    /* USER CODE END WHILE */

    /* USER CODE BEGIN 3 */
	  
	  
	  OV7670_tftlcd();
	  if(HAL_GetTick() - start_tick >= 1000)
      {
        fps = frame_cnt;       //把这一秒的帧数赋值给fps
        frame_cnt = 0;         //清零计数器，重新统计下一秒
        start_tick = HAL_GetTick(); //重置计时起点
      }
	
	
	LCD_ShowIntNum(48,150,fps,3,RED,WHITE,16);
	LCD_ShowHexNum(80, 150, val1, 3, RED, WHITE, 16);
	LCD_ShowHexNum(120, 150, val2, 3, RED, WHITE, 16);
	LCD_ShowHexNum(160, 150, val3, 3, RED, WHITE, 16);
	LCD_ShowHexNum(200, 150, val4, 3, RED, WHITE, 16);
	LCD_ShowHexNum(48, 190, val5, 3, RED, WHITE, 16);
  }
  /* USER CODE END 3 */
}

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
