LiDai1234/Edge_Detection_Accelerator/project_package/Camera_STM32F407/Core/Inc/main.h

#define LED_Pin GPIO_PIN_2
#define LED_GPIO_Port GPIOE
#define PWDN_Pin GPIO_PIN_10
#define PWDN_GPIO_Port GPIOC
#define RESTE_Pin GPIO_PIN_11
#define RESTE_GPIO_Port GPIOC
#define HREY_Pin GPIO_PIN_12
#define HREY_GPIO_Port GPIOC
#define LCD_BLK_Pin GPIO_PIN_6
#define LCD_BLK_GPIO_Port GPIOB
#define LCD_CS_Pin GPIO_PIN_7
#define LCD_CS_GPIO_Port GPIOB
#define LCD_DC_Pin GPIO_PIN_8
#define LCD_DC_GPIO_Port GPIOB
#define LCD_RES_Pin GPIO_PIN_9
#define LCD_RES_GPIO_Port GPIOB
#define LCD_MOSI_Pin GPIO_PIN_0
#define LCD_MOSI_GPIO_Port GPIOE
#define LCD_SCLK_Pin GPIO_PIN_1
#define LCD_SCLK_GPIO_Port GPIOE
