LiDai1234/Edge_Detection_Accelerator/project_package/Camera_STM32F407/Hardware/pic.h

#ifndef __PIC_H
#define __PIC_H

const unsigned char gImage_1[3200] = { /* 0X10,0X10,0X00,0X28,0X00,0X28,0X01,0X1B, */
0XFF,0XFF,0XFF,0XFF,0XFF,0XFF,0XFF,0XFF,0XFF,0XFF,0XFF,0XFF,0XFF,0XFF,0XFF,0XFF,
0XFF,0XFF,0XFF,0XFF,0XFF,0XFF,0XFF,0XFF,0XFF,0XFF,0XFF,0XFF,0XFF,0XFF,0XF7,0XBE,
0XFF,0XFF,0XFF,0XDE,0XC6,0X38,0X8C,0X92,0X6B,0X8E,0X6B,0X6E,0X7C,0X10,0XAD,0X96,
0XE7,0X3C,0XFF,0XFF,0XFF,0XFF,0XFF,0XFF,0XFF,0XFF,0XFF,0XFF,0XFF,0XFF,0XFF,0XFF,
0XFF,0XFF,0XFF,0XFF,0XFF,0XFF,0XFF,0XFF,0XFF,0XFF,0XFF,0XFF,0XFF,0XFF,0XFF,0XFF,
0XFF,0XFF,0XFF,0XFF,0XFF,0XFF,0XFF,0XFF,0XFF,0XFF,0XFF,0XFF,0XFF,0XFF,0XFF,0XFF,
0XFF,0XFF,0XFF,0XFF,0XFF,0XFF,0XFF,0XFF,0XFF,0XFF,0XFF,0XFF,0XFF,0XFF,0XEF,0X5D,
0X9D,0X15,0X63,0X4F,0X42,0X6C,0X32,0X0A,0X29,0X88,0X19,0X46,0X19,0X25,0X21,0X45,
0X31,0XE8,0X6B,0X8E,0XC6,0X38,0XFF,0XFF,0XFF,0XFF,0XFF,0XFF,0XFF,0XFF,0XFF,0XFF,
0XFF,0XFF,0XFF,0XFF,0XFF,0XFF,0XFF,0XFF,0XFF,0XFF,0XFF,0XFF,0XFF,0XFF,0XFF,0XFF,
0XFF,0XFF,0XFF,0XFF,0XFF,0XFF,0XFF,0XFF,0XFF,0XFF,0XFF,0XFF,0XFF,0XFF,0XFF,0XFF,
0XFF,0XFF,0XFF,0XFF,0XFF,0XFF,0XFF,0XFF,0XFF,0XFF,0XFF,0XFF,0XA5,0X36,0X53,0X10,
0X4B,0X10,0X53,0X51,0X4B,0X0F,0X3A,0X6C,0X31,0XE9,0X21,0X67,0X19,0X25,0X10,0XE4,
0X08,0XA3,0X00,0X62,0X08,0X83,0X52,0XCB,0XD6,0X9A,0XFF,0XFF,0XFF,0XFF,0XFF,0XFF,
0XFF,0XFF,0XFF,0XFF,0XFF,0XFF,0XFF,0XFF,0XFF,0XFF,0XFF,0XFF,0XFF,0XFF,0XFF,0XFF,
0XFF,0XFF,0XFF,0XFF,0XFF,0XFF,0XFF,0XFF,0XFF,0XFF,0XFF,0XFF,0XFF,0XFF,0XFF,0XFF,
0XFF,0XFF,0XFF,0XFF,0XFF,0XFF,0XFF,0XFF,0XE7,0X3C,0X63,0X70,0X63,0XB3,0X7C,0XB8,
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
0X9D,0X16,0X9C,0XF6,0X9D,0X16,0X9D,0X16,0X9D,0X16,0X9C,0XF6,0X9D,0X16,0X9D,0X16,
0X9C,0XF6,0X9D,0X16,0X6B,0XB1,0X8C,0X94,0X9D,0X37,0X9D,0X16,0X94,0XD5,0X9C,0XF6,
0XAD,0X57,0XAD,0X57,0XAD,0X57,0XAD,0X57,0XAD,0X57,0XAD,0X77,0XAD,0X78,0XA5,0X57,
0XAD,0X78,0XA5,0X37,0X9D,0X16,0XA5,0X37,0XA5,0X57,0XA5,0X37,0XA5,0X37,0XA5,0X17,
0X9D,0X16,0X8C,0X94,0X7C,0X12,0X7C,0X12,0X6B,0X90,0X7C,0X12,0X8C,0XB5,0X52,0XCE,
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
