LiDai1234/Edge_Detection_Accelerator/project_package/Camera_STM32F407/Hardware/sccb.c

#include "stm32f4xx_hal.h"
#include "sccb.h"
#include "HAL_Delay.h"

/**************************************************************************************
 * 描  述 : OV7670芯片SCCB接口对应IO口初始化
 * 入  参 : 无
 * 返回值 : 无
 **************************************************************************************/
void SCCB_GPIO_Init(void)
{
	GPIO_InitTypeDef GPIO_InitStructure = {0};

	// 使能GPIOB时钟（SDA=PB11, SCL=PB10）
	__HAL_RCC_GPIOB_CLK_ENABLE();

	// SCL PB5 推挽输出
	GPIO_InitStructure.Pin = GPIO_PIN_5;
	GPIO_InitStructure.Mode = GPIO_MODE_OUTPUT_PP;
	GPIO_InitStructure.Pull = GPIO_NOPULL;
	GPIO_InitStructure.Speed = GPIO_SPEED_FREQ_HIGH;
	HAL_GPIO_Init(GPIOB, &GPIO_InitStructure);

	// SDA PB4 推挽输出（初始状态）
	GPIO_InitStructure.Pin = GPIO_PIN_4;
	GPIO_InitStructure.Mode = GPIO_MODE_OUTPUT_PP;
	GPIO_InitStructure.Pull = GPIO_NOPULL;
	GPIO_InitStructure.Speed = GPIO_SPEED_FREQ_HIGH;
	HAL_GPIO_Init(GPIOB, &GPIO_InitStructure);

	SCCB_SDA_H;
	SCCB_SCL_H;
}

/**************************************************************************************
 * 描  述 : 配置OV7670芯片SCCB接口SDA为输出
 * 入  参 : 无
 * 返回值 : 无
 **************************************************************************************/
void SCCB_SDA_OUT(void)
{
	GPIO_InitTypeDef GPIO_InitStructure = {0};
	__HAL_RCC_GPIOB_CLK_ENABLE();

	GPIO_InitStructure.Pin = GPIO_PIN_4;
	GPIO_InitStructure.Mode = GPIO_MODE_OUTPUT_PP;
	GPIO_InitStructure.Pull = GPIO_NOPULL;
	GPIO_InitStructure.Speed = GPIO_SPEED_FREQ_HIGH;
	HAL_GPIO_Init(GPIOB, &GPIO_InitStructure);
}

/**************************************************************************************
 * 描  述 : 配置OV7670芯片SCCB接口SDA为输入
 * 入  参 : 无
 * 返回值 : 无
 **************************************************************************************/
void SCCB_SDA_IN(void)
{
	GPIO_InitTypeDef GPIO_InitStructure = {0};
	__HAL_RCC_GPIOB_CLK_ENABLE();

	GPIO_InitStructure.Pin = GPIO_PIN_4;
	GPIO_InitStructure.Mode = GPIO_MODE_INPUT;
	GPIO_InitStructure.Pull = GPIO_PULLUP; //上拉输入
	HAL_GPIO_Init(GPIOB, &GPIO_InitStructure);
}

/**************************************************************************************
 * 描  述 : 配置OV7670芯片SCCB接口起始信号(模拟SCCB)
 * 入  参 : 无
 * 返回值 : 无
 **************************************************************************************/
void SCCB_Start(void)
{
    SCCB_SDA_H;
    SCCB_SCL_H;
    HAL_Delay_us(50);
    SCCB_SDA_L;
    HAL_Delay_us(50);
    SCCB_SCL_L;
}

/**************************************************************************************
 * 描  述 : 配置OV7670芯片SCCB接口停止信号(模拟SCCB)
 * 入  参 : 无
 * 返回值 : 无
 **************************************************************************************/
void SCCB_Stop(void)
{
    SCCB_SDA_L;
    HAL_Delay_us(50);
    SCCB_SCL_H;
    HAL_Delay_us(50);
    SCCB_SDA_H;
    HAL_Delay_us(50);
}

/**************************************************************************************
 * 描  述 : 配置OV7670芯片SCCB接口产生NAK信号(模拟SCCB)
 * 入  参 : 无
 * 返回值 : 无
 **************************************************************************************/
void SCCB_No_Ack(void)
{
	HAL_Delay_us(50);
	SCCB_SDA_H;
	SCCB_SCL_H;
	HAL_Delay_us(50);
	SCCB_SCL_L;
	HAL_Delay_us(50);
	SCCB_SDA_L;
	HAL_Delay_us(50);
}

/**************************************************************************************
 * 描  述 : OV7670芯片SCCB接口写一个字节数据(模拟SCCB)
 * 入  参 : 无
 * 返回值 : 0,成功;1,失败.
 **************************************************************************************/
uint8_t SCCB_WriteAbyte(uint8_t dat)
{
	uint8_t i,temp;
	for(i=0;i<8;i++)     //循环8次发送一个字节数据
	{
		if(dat&0x80)
			SCCB_SDA_H;
		else
			SCCB_SDA_L;
		dat<<=1;
		HAL_Delay_us(50);
		SCCB_SCL_H;
		HAL_Delay_us(50);
		SCCB_SCL_L;
	}
	SCCB_SDA_IN();		  //设置SDA为输入
	HAL_Delay_us(50);
	SCCB_SCL_H;			    //接收第九位,以判断是否发送成功
	HAL_Delay_us(50);
	if(SCCB_Read_SDA)
		temp=1;           //SDA信号为高电平表示发送失败，返回1
	else
		temp=0;           //SDA信号为低电平表示发送成功，返回0
	SCCB_SCL_L;
	SCCB_SDA_OUT();		  //读取SDA信号后，需设置SDA为输出
	return temp;
}

/**************************************************************************************
 * 描  述 : OV7670芯片SCCB接口读一个字节数据(模拟SCCB)
 * 入  参 : 无
 * 返回值 : 读到的一个字节数据
 **************************************************************************************/
uint8_t SCCB_ReadAbyte(void)
{
	uint8_t i,temp;
	temp=0;             //对临时变量初始化值为0
	SCCB_SDA_IN();		  //设置SDA为输入
	for(i=8;i>0;i--) 	  //循环8次接收数据
	{
		HAL_Delay_us(50);
		SCCB_SCL_H;
		temp=temp<<1;
		if(SCCB_Read_SDA)
			temp++;
		HAL_Delay_us(50);
		SCCB_SCL_L;
	}
	SCCB_SDA_OUT();		 //读取SDA信号后，需设置SDA为输出
	return temp;
}

/**************************************************************************************
 * 描  述 : OV7670芯片SCCB接口写寄存器操作(模拟SCCB)
 * 入  参 : 无
 * 返回值 : 0,成功;1,失败.
 **************************************************************************************/
uint8_t SCCB_Write_Reg(uint8_t reg,uint8_t data)
{
	uint8_t temp=0;
	SCCB_Start(); 					            //启动SCCB传输
	if(SCCB_WriteAbyte(OV7670_ID))
		temp=1;	                          //写器件ID
	HAL_Delay_us(100);
  if(SCCB_WriteAbyte(reg))
		temp=1;		                        //写寄存器地址
	HAL_Delay_us(100);
  if(SCCB_WriteAbyte(data))
		temp=1; 	                        //写数据
  SCCB_Stop();	                      //结束SCCB传输
  return	temp;
}

/**************************************************************************************
 * 描  述 : OV7670芯片SCCB接口读寄存器操作(模拟SCCB)
 * 入  参 : 无
 * 返回值 : 读到的寄存器值
 **************************************************************************************/
uint8_t SCCB_Read_Reg(uint8_t reg)
{
	uint8_t temp=0;
	SCCB_Start(); 				             //启动SCCB传输
	SCCB_WriteAbyte(OV7670_ID);		       //写器件ID
	HAL_Delay_us(100);
  SCCB_WriteAbyte(reg);		           //写寄存器地址
	HAL_Delay_us(100);
	SCCB_Stop();   	                   //结束SCCB传输
	HAL_Delay_us(100);
	SCCB_Start(); 				             //启动SCCB传输
	SCCB_WriteAbyte(OV7670_ID|0X01);   	 //发送读命令
	HAL_Delay_us(100);
  temp=SCCB_ReadAbyte();		         //读取数据
  SCCB_No_Ack();                     //发送NAK信号
  SCCB_Stop();  	                   //结束SCCB传输
  return temp;
}
