LiDai1234/Edge_Detection_Accelerator/project_package/Camera_STM32F407/Hardware/FPGA_connect.h

#ifndef __FPGA_CONNECT_H
#define __FPGA_CONNECT_H
#include "stm32f4xx_hal.h"

#define FPGA_DATA_PORT GPIOD
#define FPGA_DATA_PIN (GPIO_PIN_0|GPIO_PIN_1|GPIO_PIN_2|\
GPIO_PIN_3|GPIO_PIN_4|GPIO_PIN_5|GPIO_PIN_6|GPIO_PIN_7|\
GPIO_PIN_8|GPIO_PIN_9|GPIO_PIN_10|GPIO_PIN_11|\
GPIO_PIN_12|GPIO_PIN_13|GPIO_PIN_14|GPIO_PIN_15)

void FPGA_DATA_Init(void);
void FPGA_PC8_Init(void);

#endif
