LiDai1234/Edge_Detection_Accelerator/project_package/Camera_STM32F407/Hardware/lcd_init.h

#ifndef __LCD_INIT_H
#define __LCD_INIT_H
#include "gpio.h"

#define USE_HORIZONTAL 0  //设置横屏或者竖屏显示 0或1为竖屏 2或3为横屏


#define LCD_W 240
#define LCD_H 240



//-----------------LCD端口定义---------------- 

#define LCD_SCLK_Clr() HAL_GPIO_WritePin(GPIOE,LCD_SCLK_Pin,GPIO_PIN_RESET)//SCL=SCLK
#define LCD_SCLK_Set() HAL_GPIO_WritePin(GPIOE,LCD_SCLK_Pin,GPIO_PIN_SET)

#define LCD_MOSI_Clr() HAL_GPIO_WritePin(GPIOE,LCD_MOSI_Pin,GPIO_PIN_RESET)//SDA=MOSI
#define LCD_MOSI_Set() HAL_GPIO_WritePin(GPIOE,LCD_MOSI_Pin,GPIO_PIN_SET)

#define LCD_RES_Clr()  HAL_GPIO_WritePin(GPIOB,LCD_RES_Pin,GPIO_PIN_RESET)//RES
#define LCD_RES_Set()  HAL_GPIO_WritePin(GPIOB,LCD_RES_Pin,GPIO_PIN_SET)

#define LCD_DC_Clr()   HAL_GPIO_WritePin(GPIOB,LCD_DC_Pin,GPIO_PIN_RESET)//DC
#define LCD_DC_Set()   HAL_GPIO_WritePin(GPIOB,LCD_DC_Pin,GPIO_PIN_SET)
 		     
#define LCD_CS_Clr()   HAL_GPIO_WritePin(GPIOB,LCD_CS_Pin,GPIO_PIN_RESET)//CS
#define LCD_CS_Set()   HAL_GPIO_WritePin(GPIOB,LCD_CS_Pin,GPIO_PIN_SET)

#define LCD_BLK_Clr()  HAL_GPIO_WritePin(GPIOB,LCD_BLK_Pin,GPIO_PIN_RESET)//BLK
#define LCD_BLK_Set()  HAL_GPIO_WritePin(GPIOB,LCD_BLK_Pin,GPIO_PIN_SET)





void LCD_Writ_Bus(uint8_t dat);//模拟SPI时序
void LCD_WR_DATA8(uint8_t dat);//写入一个字节
void LCD_WR_DATA(uint16_t dat);//写入两个字节
void LCD_WR_REG(uint8_t dat);//写入一个指令
void LCD_Address_Set(uint16_t x1,uint16_t y1,uint16_t x2,uint16_t y2);//设置坐标函数
void LCD_Init(void);//LCD初始化
#endif
