LiDai1234/Edge_Detection_Accelerator/(notices)

Notices in the files:
project_package/Camera_STM32F407/Core/Src/main.c:
Copyright (c) 2026 STMicroelectronics.
All rights reserved.
This software is licensed under terms that can be found in the LICENSE file
